dremugit/FlySky-FSi6-more-switches/IMG_2724.JPG

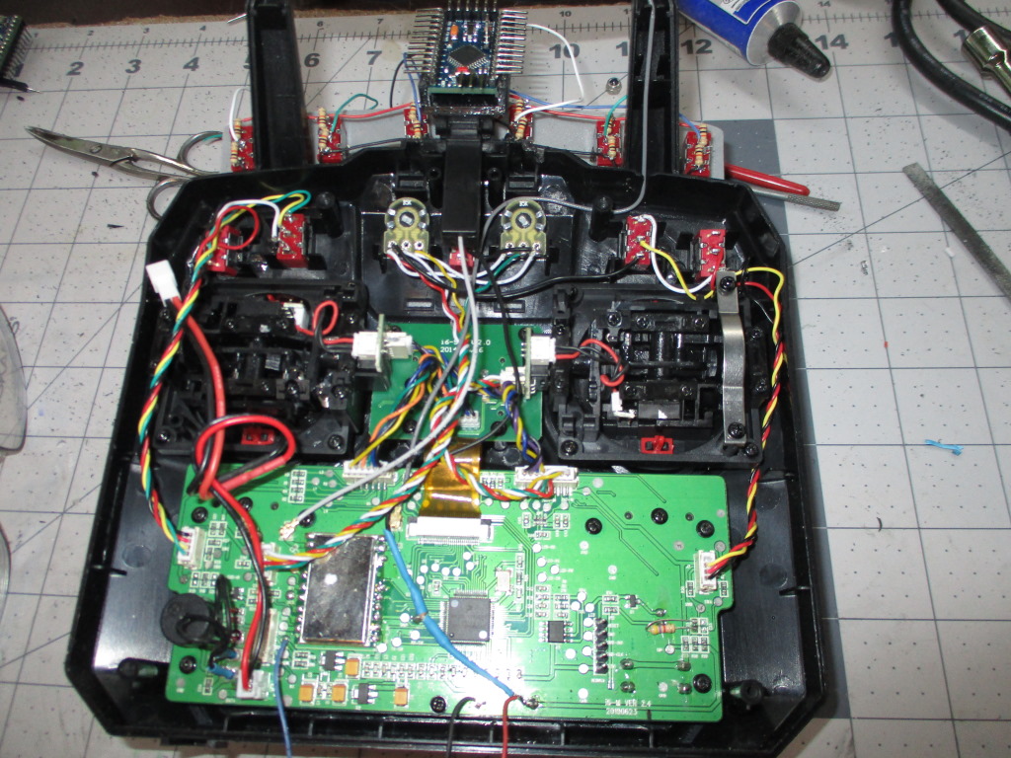
IMG_2724.JPG
